Plutov23/SmartPetFeeder/hardware/README.md

# 硬件资料

- `bom.csv`：原型所需的主要元器件清单。
- 接口定义和供电说明见 `../docs/hardware.md`。

当前整理版本没有可确认属于项目原创且可公开授权的完整原理图、PCB 和机械结构文件，因此没有将原始目录中的模块数据手册和第三方原理图复制进来。

后续补充硬件设计时，建议加入：

- 可编辑的原理图源文件和 PDF 导出文件
- PCB 源文件、Gerber 和坐标文件
- 机械结构源文件、STL/STEP 和装配图
- 电源预算、接口保护和电机堵转测试记录
- 负载传感器安装与标定说明
