Plutov23/SmartPetFeeder/THIRD_PARTY_NOTICES.md

# 第三方组件说明

本仓库根目录的 MIT License 仅适用于项目自行编写的代码和文档。下列第三方组件继续使用其目录内附带的原始许可证：

| 组件 | 位置 | 许可证文件 |
| --- | --- | --- |
| ARM CMSIS | `firmware/stm32f103/Drivers/CMSIS` | `Drivers/CMSIS/LICENSE.txt` |
| STM32F1 CMSIS Device | `firmware/stm32f103/Drivers/CMSIS/Device/ST/STM32F1xx` | `Drivers/CMSIS/Device/ST/STM32F1xx/LICENSE.txt` |
| STM32F1 HAL Driver | `firmware/stm32f103/Drivers/STM32F1xx_HAL_Driver` | `Drivers/STM32F1xx_HAL_Driver/LICENSE.txt` |

MaixPy、YOLOv5 模型、微信开发者工具、Keil MDK 和 OneNET 服务不随本仓库分发。使用者应分别遵守对应项目或服务的许可证与条款。

原始资料目录中的模块手册、教程工程、视频配套源码和论文附件没有复制到本仓库。需要这些资料时，请从制造商或原作者的官方渠道获取。
