Plutov23/SmartPetFeeder/assets/README.md

# 项目视觉素材

| 目录 | 内容 |
| --- | --- |
| <code>diagrams/</code> | 系统架构、接线、数据流和部署图 |
| <code>photos/</code> | 真实硬件与机械结构照片 |
| <code>screenshots/</code> | Keil、日志、OneNET、MaixCam 和小程序截图 |
| <code>video/</code> | 演示视频脚本、封面和发布说明 |

公开素材前请按照 [视觉素材制作计划](../docs/visual-content-plan.md) 完成脱敏。
