Plutov23/SmartPetFeeder/assets/photos/README.md

# 实物照片

本目录用于存放真实设备照片。拍摄清单、命名和隐私要求见 [视觉素材制作计划](../../docs/visual-content-plan.md)。

不要使用网络图片替代真实设备，也不要提交包含账号、密钥或个人信息的照片。
