Plutov23/SmartPetFeeder/assets/screenshots/README.md

# 软件截图

本目录用于存放构建、日志、OneNET、MaixCam 和微信小程序截图。

提交前必须隐藏 Wi-Fi、Token、Authorization、AppID、设备密钥和个人账号。完整清单见 [视觉素材制作计划](../../docs/visual-content-plan.md)。
