Plutov23/SmartPetFeeder/assets/video/README.md

# 演示视频

本目录用于存放视频分镜、字幕、封面和发布说明。原始视频不建议直接提交到 Git 仓库，应保存到发布平台或独立的大文件存储。

拍摄片段要求见 [视觉素材制作计划](../../docs/visual-content-plan.md)。
