Plutov23/SmartPetFeeder/miniapp/wechat/README.md

# 微信小程序

小程序提供：

- 温度、湿度和重量显示。
- MaixCam 局域网视频画面。
- 手动出粮。
- 最多 5 个喂食计划。
- 本机喂食记录和进食健康记录。

导入微信开发者工具前，复制 `config.example.js` 为 `config.js` 并填写本地配置。仓库中的 `project.config.json` 使用 `touristappid`，正式调试和发布时请在本地使用自己的 AppID。

当前记录保存在 `wx` 本地存储中，清理小程序数据或更换设备后不会自动恢复。
