Plutov23/SmartPetFeeder/tutorials/beginner/appendices/购买清单.md

# 元器件和工具购买清单

## 核心模块

| 名称 | 建议规格 | 数量 | 购买时确认 |
| --- | --- | ---: | --- |
| STM32 开发板 | STM32F103C8T6 | 1 | 能使用 SWD 下载 |
| ST-Link | 支持 STM32 SWD | 1 | 带 SWDIO、SWCLK、GND |
| USB 转 TTL | 支持 3.3 V 逻辑 | 1 | 能选择合适电平 |
| OLED | SSD1306 128×64 | 1 | 确认供电和接口 |
| AHT20 | I2C 模块 | 1 | 模块板带清楚丝印 |
| DS1302 | 带后备电池座 | 1 | 确认电池型号 |
| HX711 | 压力传感器 ADC | 1 | 有 E+/E-/A+/A- |
| 压力传感器 | 适合粮仓最大重量 | 1 | 不要长期超量程 |
| 步进电机 | 28BYJ-48 5 V | 1 | 确认是 5 V 版本 |
| 电机驱动 | ULN2003 | 1 | 与电机插头匹配 |
| Wi-Fi 模块 | ESP-01S | 1 | 固件支持 MQTT AT |
| AI 摄像头 | MaixCam | 1 | 系统支持当前 MaixPy API |
| 有源蜂鸣器 | 3.3 V 兼容 | 1 | 确认有效电平 |

## 电源和接线

| 名称 | 用途 |
| --- | --- |
| 稳定 5 V 电源 | 电机和部分模块 |
| 稳定 3.3 V 电源 | ESP-01S、STM32 和传感器 |
| 杜邦线 | 模块连接 |
| 面包板 | 初期低电流实验 |
| 220 Ω～1 kΩ 电阻 | LED 限流 |
| LED | GPIO 学习实验 |
| 开关和保险保护 | 原型供电安全 |

不要让面包板长期承载电机大电流。

## 推荐工具

| 工具 | 用途 |
| --- | --- |
| 数字万用表 | 测量电压、通断和短路 |
| 小螺丝刀 | 固定端子 |
| 镊子 | 整理小连接件 |
| 扎带或线标 | 整理和标记线路 |
| 手机支架 | 拍摄教程和演示视频 |

有条件时可以使用示波器观察电源跌落和通信波形，但不是入门必需品。

## 购买前必须确认

- 模块工作电压
- 引脚名称和接口类型
- 电机额定电压
- 压力传感器量程
- ESP-01S 固件功能
- MaixCam 系统和模型兼容性
- 是否包含连接线、电池和驱动板

## 收到模块后

1. 拍摄正反面。
2. 记录模块型号。
3. 检查是否有损坏。
4. 标记 VCC 和 GND。
5. 不确定电压时先不要通电。

返回：[零基础教程目录](../README.md)
