Plutov23/SmartPetFeeder/tutorials/README.md

# SmartPetFeeder 从零复现教程

这里提供两条学习路线。

## 先选择适合你的路线

### 完全零基础

如果你刚上大学，还没有学过单片机、电路或 C 语言，请先阅读：

[零基础入门路线](beginner/README.md)

零基础路线会先解释名词，再带你完成一个个很小的实验。你不需要一开始就看懂完整工程。

### 已经接触过单片机

下面的第 0～10 章是技术参考路线，适合具备基础 C 语言知识、第一次尝试完整嵌入式项目的大学生。

## 最终成果

完成全部章节后，你将搭建一台能够实现以下功能的原型机：

- 定时、定量出粮
- 手机远程手动喂食
- 温湿度和余粮重量监测
- OLED 本地状态显示
- 猫狗目标检测和进食状态判断
- 进食时长与消耗重量记录
- 微信小程序数据展示和局域网视频预览

## 学习路线

| 章节 | 内容 | 状态 |
| --- | --- | --- |
| [第 0 章](00-项目介绍.md) | 项目介绍、系统架构与学习方法 | 已完成 |
| [第 1 章](01-硬件准备与接线.md) | 元器件、供电、引脚和分阶段接线 | 已完成 |
| [第 2 章](02-STM32工程与首次运行.md) | STM32 工程、时钟、GPIO 和串口日志 | 已完成 |
| [第 3 章](03-HX711称重与标定.md) | HX711 称重、去皮与标定 | 已完成 |
| [第 4 章](04-步进电机与出粮标定.md) | 步进电机控制和每克步数标定 | 已完成 |
| [第 5 章](05-显示传感器与实时时钟.md) | OLED、AHT20 和 DS1302 | 已完成 |
| [第 6 章](06-ESP01S与OneNET.md) | ESP-01S、MQTT 和 OneNET | 已完成 |
| [第 7 章](07-MaixCam视觉识别.md) | MaixCam、YOLOv5 和 UART 状态协议 | 已完成 |
| [第 8 章](08-微信小程序.md) | 微信小程序、OneNET API 和视频流 | 已完成 |
| [第 9 章](09-系统联调.md) | 系统联调与完整运行流程 | 已完成 |
| [第 10 章](10-测试排障与改进.md) | 常见故障、测试方法和改进方向 | 已完成 |

## 推荐基础

开始前最好了解：

- C 语言变量、函数、结构体和数组
- GPIO 输入输出的基本概念
- 串口 TX、RX、波特率和共地
- 能够使用 Keil 创建、编译和烧录 STM32 工程
- 会使用万用表测量直流电压和通断

不要求提前掌握 MQTT、目标检测或微信小程序。相关概念会在对应章节解释。

## 教程约定

每一章都采用相同结构：

1. 本章目标
2. 原理说明
3. 硬件或软件准备
4. 分步骤实现
5. 预期现象
6. 验证清单
7. 常见错误

出现问题时，不要同时修改多个模块。先确认电源，再确认单个模块，最后检查模块之间的通信。

## 安全与隐私

- 不要把真实 Wi-Fi 密码、OneNET Token、微信 AppID 密钥提交到 Git。
- 电机必须经过驱动模块供电，禁止直接连接 STM32 GPIO。
- 不确定模块电压时，先查阅所购买板卡的官方资料。
- 更改接线前先断电。
- 原型机不应在无人看管时长期运行。

## 获取代码

克隆仓库：

```bash
git clone https://github.com/Plutov23/SmartPetFeeder.git
cd SmartPetFeeder
```

正式教程版本发布后，每一阶段会提供对应的 Git Tag。读者可以通过以下方式切换到指定版本：

```bash
git tag
git switch --detach <tag-name>
```

返回最新代码：

```bash
git switch main
```

## 反馈问题

提交 Issue 时请包含：

- 当前教程章节
- 使用的开发板和模块型号
- 供电电压
- 完整串口日志
- 实际现象与预期现象
- 已经尝试过的排查步骤

发布日志和截图前，请先隐藏 Wi-Fi、Token、设备名称、局域网地址和其他个人信息。
