Plutov23/SmartPetFeeder/tutorials/beginner/README.md

# SmartPetFeeder 零基础入门

这套教程写给第一次接触单片机、电路和物联网的同学。

你不需要提前学会 C 语言，也不需要先理解所有英文缩写。遇到新名词时，教程会马上解释。

## 学完后你能知道什么

完成整套教程后，你应该能够：

- 说出智能喂食器由哪些模块组成
- 看懂简单的接线表
- 使用 Keil 打开和编译 STM32 工程
- 使用串口查看设备运行信息
- 读取温湿度、时间和重量
- 控制步进电机出粮
- 理解设备怎样把数据发送到云平台
- 使用微信小程序查看和控制设备
- 理解 MaixCam 怎样识别猫狗
- 遇到故障时知道先检查哪里

重点不是背代码，而是理解每一部分在做什么。

## 怎么学习

一次只学习一课。

不要提前把所有模块都接上。每完成一个小实验，再增加一个模块。

每一课都会告诉你：

1. 这一课要完成什么
2. 需要准备什么
3. 要做哪些操作
4. 正确结果是什么
5. 失败时先检查什么

## 完整课程

| 课程 | 内容 | 状态 |
| --- | --- | --- |
| [第 0 课](00-怎么使用这套教程.md) | 怎么学习，遇到问题怎么办 | 已完成 |
| [第 1 课](01-认识项目和硬件.md) | 认识项目和所有模块 | 已完成 |
| [第 2 课](02-电源GND和安全接线.md) | 电压、GND 和安全接线 | 已完成 |
| [第 3 课](03-安装软件并打开工程.md) | 安装工具并第一次编译 | 已完成 |
| [第 4 课](04-点亮第一个LED.md) | 让 STM32 点亮 LED | 已完成 |
| [第 5 课](05-让STM32发送文字.md) | 让 STM32 向电脑发送文字 | 已完成 |
| [第 6 课](06-OLED显示文字.md) | 让 OLED 显示第一行文字 | 已完成 |
| [第 7 课](07-读取温湿度.md) | 读取温度和湿度 | 已完成 |
| [第 8 课](08-读取实时时间.md) | 使用 DS1302 读取时间 | 已完成 |
| [第 9 课](09-读取重量.md) | HX711 去皮、标定和称重 | 已完成 |
| [第 10 课](10-步进电机与出粮.md) | 步进电机和出粮标定 | 已完成 |
| [第 11 课](11-连接WiFi.md) | ESP-01S 连接 Wi-Fi | 已完成 |
| [第 12 课](12-连接OneNET.md) | 向 OneNET 发送数据 | 已完成 |
| [第 13 课](13-使用微信小程序.md) | 查看数据、出粮和计划 | 已完成 |
| [第 14 课](14-MaixCam识别猫狗.md) | 猫狗识别、状态和视频 | 已完成 |
| [第 15 课](15-组合完整系统.md) | 组合完整智能喂食器 | 已完成 |
| [第 16 课](16-测试排障与展示.md) | 测试、排障和项目展示 | 已完成 |

## 随时查阅的附录

- [新手术语表](appendices/新手术语表.md)
- [元器件和工具购买清单](appendices/购买清单.md)
- [STM32 引脚速查表](appendices/引脚速查表.md)
- [常见错误速查表](appendices/常见错误速查表.md)
- [测试记录模板](appendices/测试记录模板.md)
- [视频、博客、小书和短视频制作指南](appendices/内容发布与视频制作.md)

## 学习时间

不要要求自己一天完成。

建议每次学习 30～60 分钟。完成一课后，保存照片、日志和笔记，再开始下一课。

如果一节卡住超过 30 分钟，先停下来休息。重新检查电源、接线和当前步骤，不要同时修改很多地方。

## 安全规则

- 接线前先断电
- 不知道模块电压时不要通电
- 电机不能直接连接 STM32 引脚
- 不要用手触摸正在发热的模块
- 出现异味、冒烟或明显发热时立即断电
- 不要把 Wi-Fi 密码和设备密钥发到公开网站
- 原型设备不要在无人看管时长期运行

## 技术参考版

零基础教程会省略部分复杂原理。想进一步了解时，可以阅读[技术参考路线](../README.md)。

从这里开始：[第 0 课：怎么使用这套教程](00-怎么使用这套教程.md)
