Plutov23/SmartPetFeeder/tutorials/beginner/appendices/测试记录模板.md

# 测试记录模板

复制下面内容，为每次重要测试建立一份记录。

## 基本信息

~~~text
测试日期：
测试人员：
Git 提交号或版本：
STM32 板卡型号：
ESP-01S 固件版本：
MaixCam 系统版本：
小程序版本：
供电方式：
~~~

不要在记录中填写真实密码、Token 或 Authorization。

## 测试目标

~~~text
本次要验证什么：
预期结果：
~~~

## 接线和配置

~~~text
新增或修改的模块：
使用的引脚：
修改的配置项：
使用的标定参数：
~~~

## 操作步骤

~~~text
1.
2.
3.
4.
~~~

## 实际结果

~~~text
实际现象：
是否达到预期：
最后一条串口日志：
OneNET 状态：
小程序状态：
~~~

## 出粮测试表

| 次数 | 目标重量 | 实际重量 | 误差 | 是否卡粮 |
| ---: | ---: | ---: | ---: | --- |
| 1 |  |  |  |  |
| 2 |  |  |  |  |
| 3 |  |  |  |  |
| 4 |  |  |  |  |
| 5 |  |  |  |  |

## 问题处理

~~~text
问题发生在哪一步：
已经检查过什么：
修改了什么：
修改后的结果：
问题是否再次出现：
~~~

## 测试证据

- [ ] 接线照片
- [ ] 串口日志
- [ ] Keil 编译结果
- [ ] OneNET 截图
- [ ] 小程序截图
- [ ] 演示视频

## 结论

~~~text
通过 / 不通过：
还需要改进什么：
下一次测试计划：
~~~

返回：[零基础教程目录](../README.md)
