Plutov23/SmartPetFeeder/CHANGELOG.md

# 更新记录

## Unreleased

- 建立统一的开源项目目录。
- 整合 STM32F103 固件、MaixCam 视觉程序和微信小程序。
- 移除编译产物、历史安装包、IDE 私有配置和重复参考工程。
- 将 Wi-Fi、OneNET、设备地址等敏感参数改为公开配置模板。
- 补充架构、硬件、通信协议、构建部署和安全说明。
