Plutov23/SmartPetFeeder/firmware/stm32f103/Core/Inc/main.h

#define DS1302RST_Pin GPIO_PIN_4
#define DS1302RST_GPIO_Port GPIOA
#define DS1302CLK_Pin GPIO_PIN_5
#define DS1302CLK_GPIO_Port GPIOA
#define DS1302DAT_Pin GPIO_PIN_6
#define DS1302DAT_GPIO_Port GPIOA
#define BUZZER_Pin GPIO_PIN_12
#define BUZZER_GPIO_Port GPIOB
#define LED_Pin GPIO_PIN_15
#define LED_GPIO_Port GPIOB
#define MOTOR1_Pin GPIO_PIN_4
#define MOTOR1_GPIO_Port GPIOB
#define MOTOR2_Pin GPIO_PIN_5
#define MOTOR2_GPIO_Port GPIOB
#define MOTOR3_Pin GPIO_PIN_6
#define MOTOR3_GPIO_Port GPIOB
#define MOTOR4_Pin GPIO_PIN_7
#define MOTOR4_GPIO_Port GPIOB
