Plutov23/SmartPetFeeder/(commit log)

2026-11-04 feat: prepare SmartPetFeeder open-source repository
    [bom.csv]
2026-11-04 docs: add STM32 and HX711 tutorials
